rusefi/hw_microRusEfi/zMRETestFixture.kicad_pcb

## KiCad design zMRETestFixture.kicad_pcb (2020-08-03)

Schematic: zMRETestFixture.sch

Parts:
D1, D3, D5, D7, D9, D11, D13, D15, D17, D19, D21, D24, D26, D28, D30, D32, D34, D36, D38, D40, D42, D44, D46, D48, D49, D50, D51, D52, D53, D54, D55, D56, D57, D58, D59, D60, D61, D62, D63, D64, D82, D84, D86, D88, D90, D92, D94, D95, D97: 1N4148WS; SM0805_jumper; LCSC C2128
D2, D4, D6, D65, D66, D67, D68, D69, D70, D71, D72, D73, D74, D75, D76, D77, D78, D79, D80: GRN; SM0805_jumper; LCSC C2297
D8: YEL(593NM); SM0805_jumper; LCSC C2296
D10: YEL(570NM); SM0805_jumper; LCSC C84257
D12, D14, D16, D18, D20, D22: BLU; SM0805_jumper; LCSC C375453
D23, D25, D27, D29, D31, D33, D35, D37, D39, D41, D43, D45, D47, D81, D83, D85, D87, D89, D91, D93, D96: RED; SM0805_jumper; LCSC C84256
F1: 1A FUSE; Blank; Digi 283-3731-ND
J1, J2, J5, J6, J7, J8, J10, J11: Conn_01x01; Pin_D0.7mm_L6.5mm_W1.8mm_FlatFork
J3, J4: Conn_01x01_Female; KeyStone_3557; Digi 36-3557-ND
J9: Conn_02x05_Counter_Clockwise; PinHeader_2x05_P2.54mm_Vertical_SMD
LOGO1: DNP; LOGO; Part # DNP
LOGO2: DNP; OSHW-Logo2_7.3x6mm_SilkScreen; Part # DNP
LOGO3: LOGO; MRE_QR_code
R1, R2, R7, R8, R9, R10, R11, R12, R13, R16, R20, R21, R24, R27, R33, R37, R41, R43, R45, R47, R49, R51, R53, R55, R61, R62, R63, R64, R65, R66, R67, R68, R69, R70, R71, R72, R73, R74, R75, R76, R77, R79, R81, R83, R85, R87, R89, R90, R92: 1k; SM0805_jumper; LCSC C17513
R3: 0R; SM0805_jumper; LCSC C17477
R4, R5, R6, R17, R22, R23, R28, R31, R34, R38, R40, R42, R44, R46, R48, R50, R52, R54, R56, R78, R80, R82, R84, R86, R88, R91, R93: 5k; SM0805_jumper; LCSC C17677
R14, R26, R32: 2k2; SM0805_jumper; LCSC C17520
R15, R30: 3k3; SM0805_jumper; LCSC C26010
R18, R39: 4k7; SM0805_jumper; LCSC C17673
R19, R25, R29: 10k; SM0805_jumper; LCSC C17414
SW1, SW2: SW_Push; SW_SPST_B3SL-1002P; LCSC C318887
TP1, TP3: 5V; TestPoint_Pad_D2.0mm; Part # DNP
TP2, TP4: GND; TestPoint_Pad_D2.0mm; Part # DNP
U1: molex_48pin_MRE; Molex_48_MRE; Part # 500762-0481

Connections:
/5V: D1.2 (A), J9.1, TP1.1, U1.J201, U1.J202, U1.J801
/5V1: R19.1, R23.1, R25.1, R29.1, U1.44
/5V2: R31.1, R38.1, U1.39
/12V_KEY: R3.2, U1.5
/12V_MREL: D5.2 (A), D24.2 (A), D26.2 (A), D28.2 (A), D30.2 (A), D32.2 (A), D34.2 (A), D36.2 (A), D38.2 (A), D40.2 (A), D42.2 (A), D44.2 (A), D46.2 (A), D48.2 (A), D82.2 (A), D84.2 (A), D86.2 (A), D88.2 (A), D90.2 (A), D92.2 (A), D94.2 (A), D97.2 (A), J4.1, J9.2, R3.1, R17.1, R22.1, R28.1, R34.1, R40.1, R42.1, R44.1, R46.1, R48.1, R50.1, R52.1, R54.1, R56.1, R78.1, R80.1, R82.1, R84.1, R86.1, R88.1, R91.1, R93.1, TP3.1, U1.1, U1.J802
/12V_SAFE: D95.2 (A), U1.M71, U1.M72, U1.M73
/AT1: R13.2, U1.18
/AT2: R14.2, U1.23
/AT3: R15.2, U1.24
/AT4: R18.2, U1.22
/AV1: R19.2, R20.2, U1.27
/AV2: R23.2, R24.2, U1.26
/AV3: R25.2, R26.2, U1.31
/AV4: R29.2, R30.2, U1.19
/AV5: R31.2, R32.2, U1.20
/AV6: R27.2, R28.2, U1.32
/AV7: R38.2, R39.2, U1.30
/AV8: R43.2, R44.2, U1.36
/AV9: R49.2, R50.2, U1.40
/AV10: R16.2, R17.2, U1.28
/CAM_SENSOR: J7.1, SW1.2, U1.25
/CRNK+: J5.1, J8.1, SW2.2, U1.45
/CRNK-: J6.1, U1.46
/E-THROTTLE+: D7.2 (A), D9.1 (K), U1.4
/E-THROTTLE-: R5.2, R6.2, U1.8
/GP1: R41.2, R42.2, U1.35
/GP2: R37.2, R40.2, U1.34
/GP3: R33.2, R34.2, U1.33
/GP4: R55.2, R56.2, U1.43
/GP5: D21.2 (A), U1.14
/GP6: D19.2 (A), U1.13
/IGN_OUT_1: D61.2 (A), U1.J51
/IGN_OUT_2: D62.2 (A), U1.J52
/IGN_OUT_3: D63.2 (A), U1.J53
/IGN_OUT_4: D64.2 (A), U1.J54
/INJECTOR-1: R45.2, R46.2, U1.37
/INJECTOR-2: R47.2, R48.2, U1.38
/INJECTOR-3: R51.2, R52.2, U1.41
/INJECTOR-4: R53.2, R54.2, U1.42
/Ign1: D11.2 (A), U1.9
/Ign2: D13.2 (A), U1.10
/Ign3: D15.2 (A), U1.11
/Ign4: D17.2 (A), U1.12
/LINBUS: R90.2, U1.LIN1
/LS1: R89.2, R91.2, U1.7
/LS2: R92.2, R93.2, U1.3
/MAIN_RELAY: R21.2, R22.2, U1.29
/OUT_7: R77.2, R78.2, U1.J14
/OUT_14: R79.2, R80.2, U1.J61
/OUT_15: R81.2, R82.2, U1.J62
/OUT_16: R83.2, R84.2, U1.J63
/OUT_17: R85.2, R86.2, U1.J64
/OUT_18: R87.2, R88.2, U1.J65
/PA15: D49.2 (A), J9.7, U1.J807
/PB7: D50.2 (A), U1.J18
/PB8: D51.2 (A), J9.3, U1.J803
/PB9: D52.2 (A), J9.6, U1.J806
/PC10: D53.2 (A), J9.8, U1.J808
/PC11: D54.2 (A), J9.5, U1.J805
/PC12: D55.2 (A), J9.10, U1.J810
/PC13: D56.2 (A), U1.J9
/PD0: D57.2 (A), U1.J16
/PE0: D58.2 (A), U1.J6
/PE5: D60.2 (A), U1.J11
/PE6: D59.2 (A), U1.J10
/VDD: D3.2 (A), J9.4, TP4.1, U1.J203, U1.J204, U1.J804
/Vrtc: J11.1, U1.J32
GND: J2.1, J9.9, J10.1, R1.1, R2.1, R4.2, R7.1, R8.1, R9.1, R10.1, R11.1, R12.1, R13.1, R14.1, R15.1, R18.1, R20.1, R24.1, R26.1, R30.1, R32.1, R39.1, R61.1, R62.1, R63.1, R64.1, R65.1, R66.1, R67.1, R68.1, R69.1, R70.1, R71.1, R72.1, R73.1, R74.1, R75.1, R76.1, SW1.1, SW2.1, TP2.1, U1.2, U1.6, U1.17, U1.21, U1.J31, U1.J207, U1.J208, U1.J809
unnamed: D1.1 (K), D2.2 (A)
unnamed: D2.1 (K), R1.2
unnamed: D3.1 (K), D4.2 (A)
unnamed: D4.1 (K), R2.2
unnamed: D5.1 (K), D6.2 (A)
unnamed: D6.1 (K), R4.1
unnamed: D7.1 (K), D8.2 (A)
unnamed: D8.1 (K), R5.1
unnamed: D9.2 (A), D10.1 (K)
unnamed: D10.2 (A), R6.1
unnamed: D11.1 (K), D12.2 (A)
unnamed: D12.1 (K), R7.2
unnamed: D13.1 (K), D14.2 (A)
unnamed: D14.1 (K), R8.2
unnamed: D15.1 (K), D16.2 (A)
unnamed: D16.1 (K), R9.2
unnamed: D17.1 (K), D18.2 (A)
unnamed: D18.1 (K), R10.2
unnamed: D19.1 (K), D20.2 (A)
unnamed: D20.1 (K), R11.2
unnamed: D21.1 (K), D22.2 (A)
unnamed: D22.1 (K), R12.2
unnamed: D23.1 (K), R16.1
unnamed: D23.2 (A), D24.1 (K)
unnamed: D25.1 (K), R21.1
unnamed: D25.2 (A), D26.1 (K)
unnamed: D27.1 (K), R27.1
unnamed: D27.2 (A), D28.1 (K)
unnamed: D29.1 (K), R33.1
unnamed: D29.2 (A), D30.1 (K)
unnamed: D31.1 (K), R37.1
unnamed: D31.2 (A), D32.1 (K)
unnamed: D33.1 (K), R41.1
unnamed: D33.2 (A), D34.1 (K)
unnamed: D35.1 (K), R43.1
unnamed: D35.2 (A), D36.1 (K)
unnamed: D37.1 (K), R45.1
unnamed: D37.2 (A), D38.1 (K)
unnamed: D39.1 (K), R47.1
unnamed: D39.2 (A), D40.1 (K)
unnamed: D41.1 (K), R49.1
unnamed: D41.2 (A), D42.1 (K)
unnamed: D43.1 (K), R51.1
unnamed: D43.2 (A), D44.1 (K)
unnamed: D45.1 (K), R53.1
unnamed: D45.2 (A), D46.1 (K)
unnamed: D47.1 (K), R55.1
unnamed: D47.2 (A), D48.1 (K)
unnamed: D49.1 (K), D65.2 (A)
unnamed: D50.1 (K), D66.2 (A)
unnamed: D51.1 (K), D67.2 (A)
unnamed: D52.1 (K), D68.2 (A)
unnamed: D53.1 (K), D69.2 (A)
unnamed: D54.1 (K), D70.2 (A)
unnamed: D55.1 (K), D71.2 (A)
unnamed: D56.1 (K), D72.2 (A)
unnamed: D57.1 (K), D73.2 (A)
unnamed: D58.1 (K), D74.2 (A)
unnamed: D59.1 (K), D75.2 (A)
unnamed: D60.1 (K), D76.2 (A)
unnamed: D61.1 (K), D77.2 (A)
unnamed: D62.1 (K), D78.2 (A)
unnamed: D63.1 (K), D79.2 (A)
unnamed: D64.1 (K), D80.2 (A)
unnamed: D65.1 (K), R61.2
unnamed: D66.1 (K), R62.2
unnamed: D67.1 (K), R63.2
unnamed: D68.1 (K), R64.2
unnamed: D69.1 (K), R65.2
unnamed: D70.1 (K), R66.2
unnamed: D71.1 (K), R67.2
unnamed: D72.1 (K), R68.2
unnamed: D73.1 (K), R69.2
unnamed: D74.1 (K), R70.2
unnamed: D75.1 (K), R71.2
unnamed: D76.1 (K), R72.2
unnamed: D77.1 (K), R73.2
unnamed: D78.1 (K), R74.2
unnamed: D79.1 (K), R75.2
unnamed: D80.1 (K), R76.2
unnamed: D81.1 (K), R77.1
unnamed: D81.2 (A), D82.1 (K)
unnamed: D83.1 (K), R79.1
unnamed: D83.2 (A), D84.1 (K)
unnamed: D85.1 (K), R81.1
unnamed: D85.2 (A), D86.1 (K)
unnamed: D87.1 (K), R83.1
unnamed: D87.2 (A), D88.1 (K)
unnamed: D89.1 (K), R85.1
unnamed: D89.2 (A), D90.1 (K)
unnamed: D91.1 (K), R87.1
unnamed: D91.2 (A), D92.1 (K)
unnamed: D93.1 (K), R89.1
unnamed: D93.2 (A), D94.1 (K)
unnamed: D95.1 (K), R90.1
unnamed: D96.1 (K), R92.1
unnamed: D96.2 (A), D97.1 (K)
unnamed: J1.1, J3.1

Notes on the sheet:
Communication Header
LIN bus termination
0.833V
1.241V
2.423V
0.455V
0.902V
1.528V
2.245V
3.176V
1.351V
2.750V

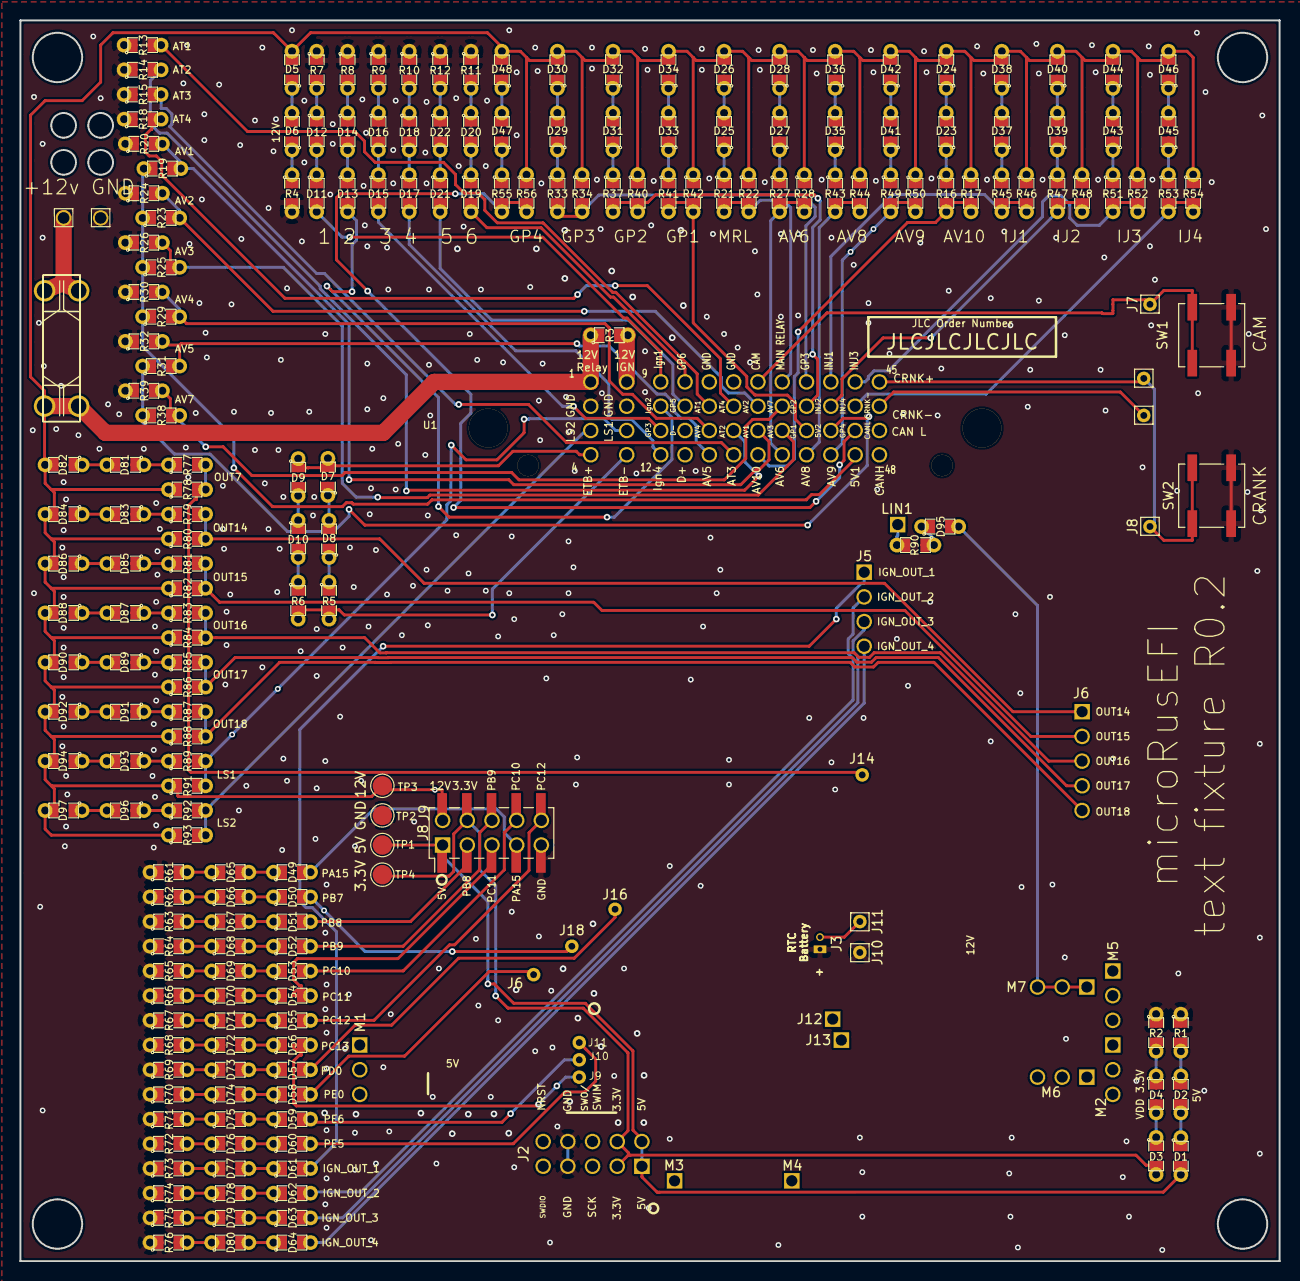
[picture p12: board zMRETestFixture.kicad_pcb from above]

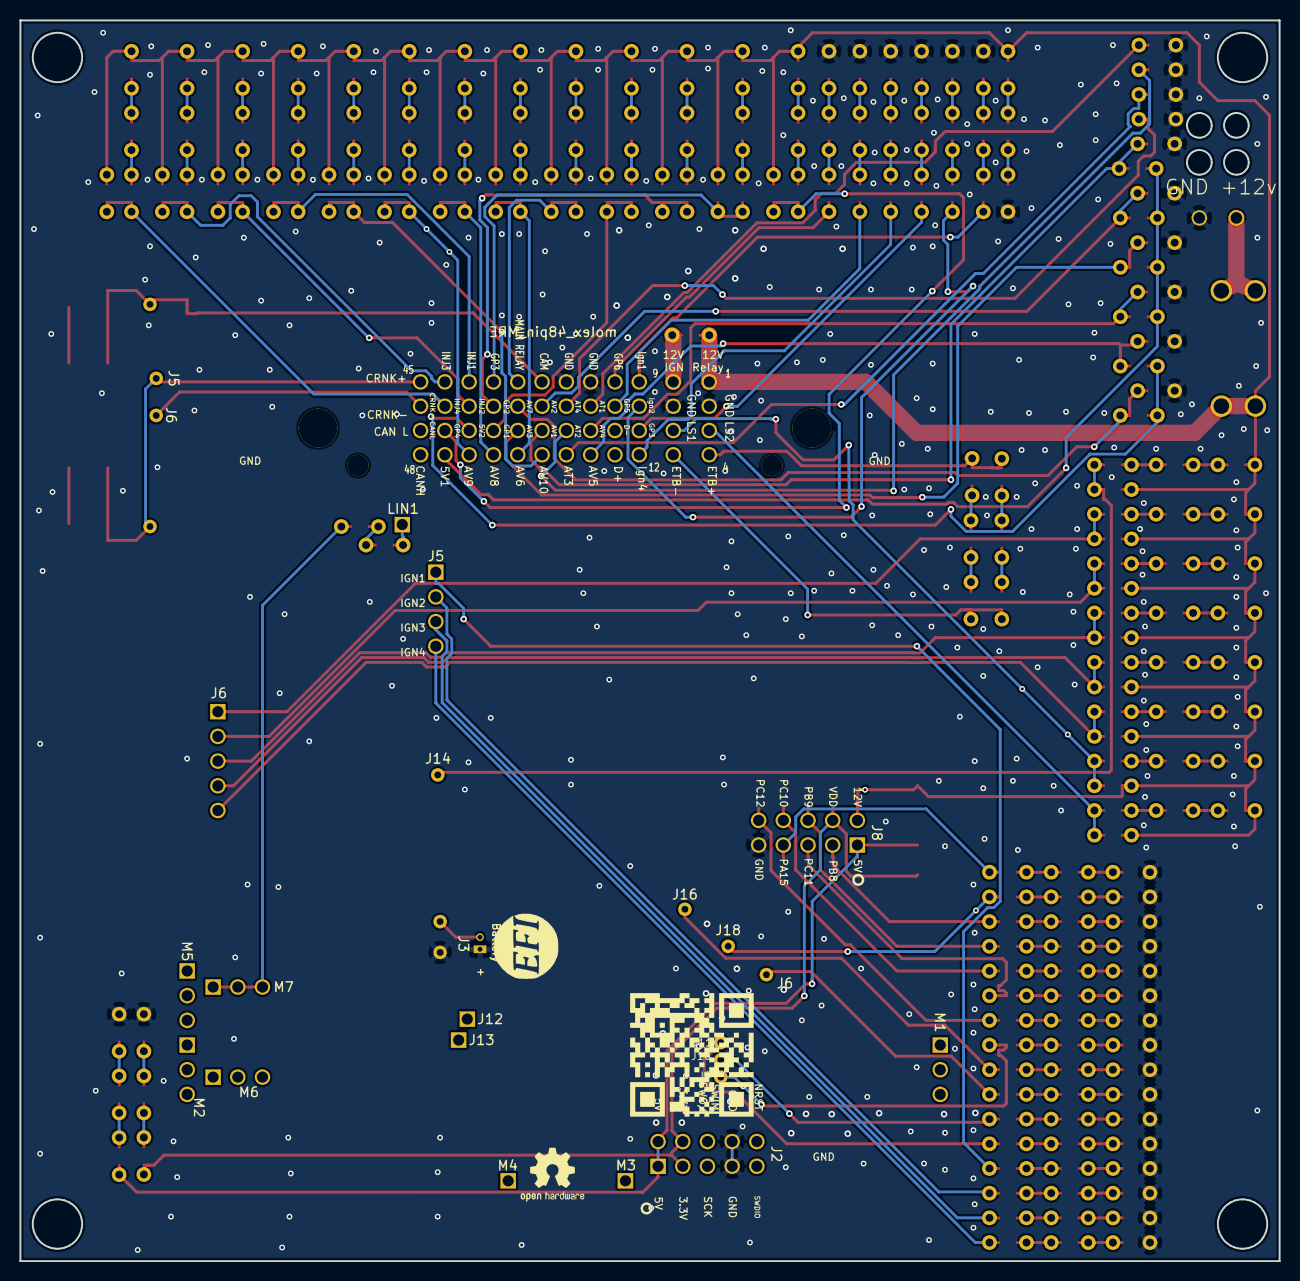
[picture p13: board zMRETestFixture.kicad_pcb from below]

Board: 2 copper layers, 129.5 x 127.6 mm, 206 parts (3 on the bottom side), 166 nets.
